vtmrg/EcoOctano-2022-Telemetria-E-Instrumentacao/WebApp/ecooctano2022.azurewebsites.net/Versão 1.0- Velocidade e Potência/Captura de Tela 2022-07-26 às 15.19.16.png

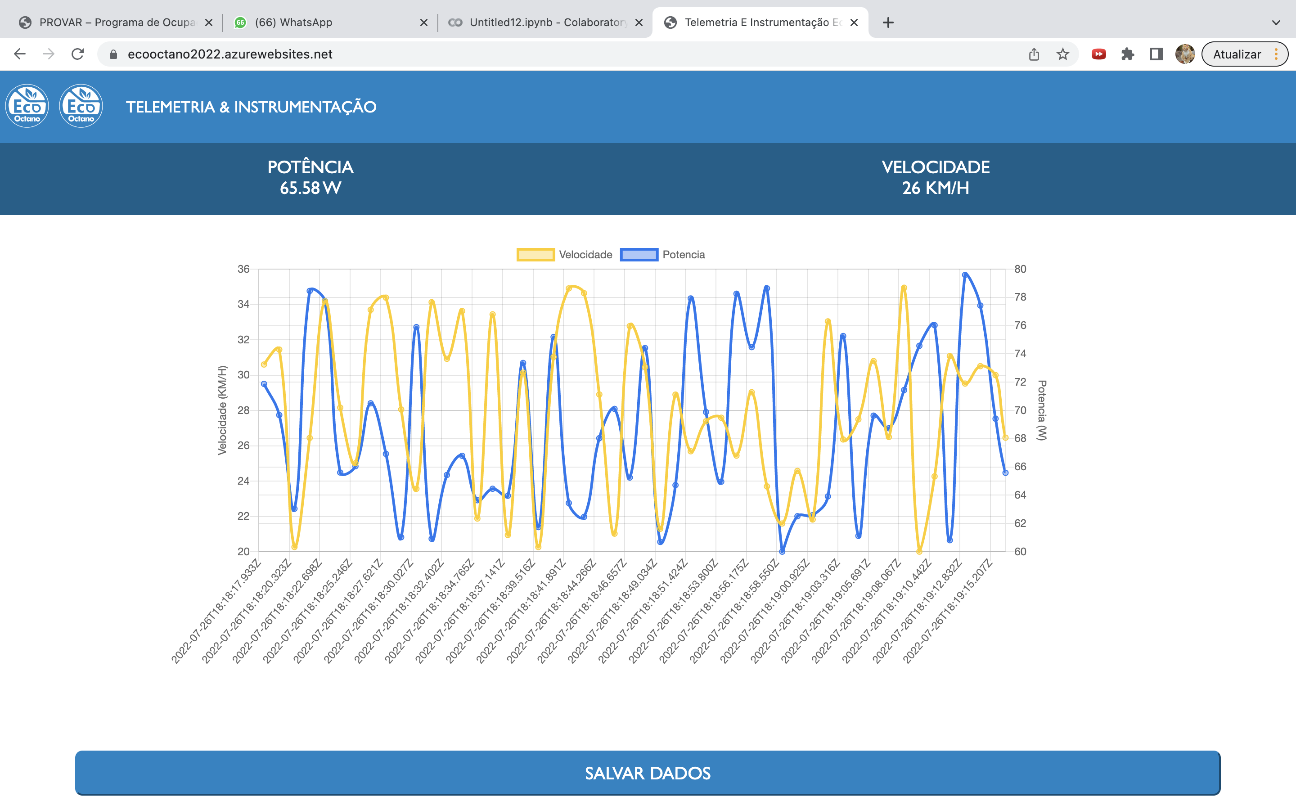
WebApp/ecooctano2022.azurewebsites.net/Versão 1.0- Velocidade e Potência/Captura de Tela 2022-07-26 às 15.19.16.png
