vtmrg/EcoOctano-2022-Telemetria-E-Instrumentacao/WebApp/ecooctano2022.azurewebsites.net/Versão 1.1- Velocidade, Distância e Potência/Captura de Tela 2022-08-08 às 11.22.30.png

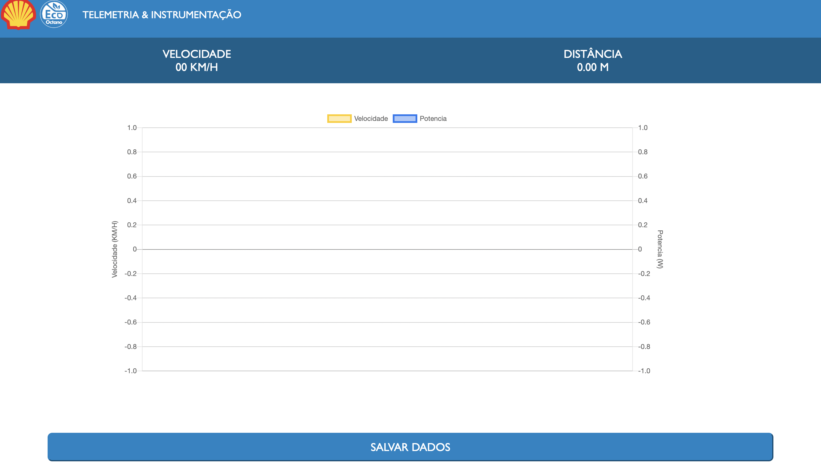
WebApp/ecooctano2022.azurewebsites.net/Versão 1.1- Velocidade, Distância e Potência/Captura de Tela 2022-08-08 às 11.22.30.png
