vtmrg/EcoOctano-2022-Telemetria-E-Instrumentacao/(commit log)

2023-03-15 Códigos e esquemáticos da PCB
2023-03-15 Revert "Delete Aquila directory"
    This reverts commit 80d33f004d92fe51a67092d76dfc5cce78549425.
    [Cdg1.2-Teensy-1_Ima-testado(prblm. roda travada e att. do site).ino, Cdg1.3-Teensy-1_Ima_-testar.ino, ESP32_Aquilla-Limpo.ino, ESP32_Aquilla-SD.ino, ESP32_Wi-fi_ECO2022.ino, ESP32_Wi-fi_TP-LINK_F15428.ino, Teensy_Aquila-1ima-Limpo.ino, Teensy_Aquila-1imaFuncional.ino]
